and3rson/caveboard/README.md

# CaveBoard

Простий комп'ютер на базі мікропроцесора MOS 6502 (W65C02).

Відео: <https://youtu.be/Klj2Q3trmW8>

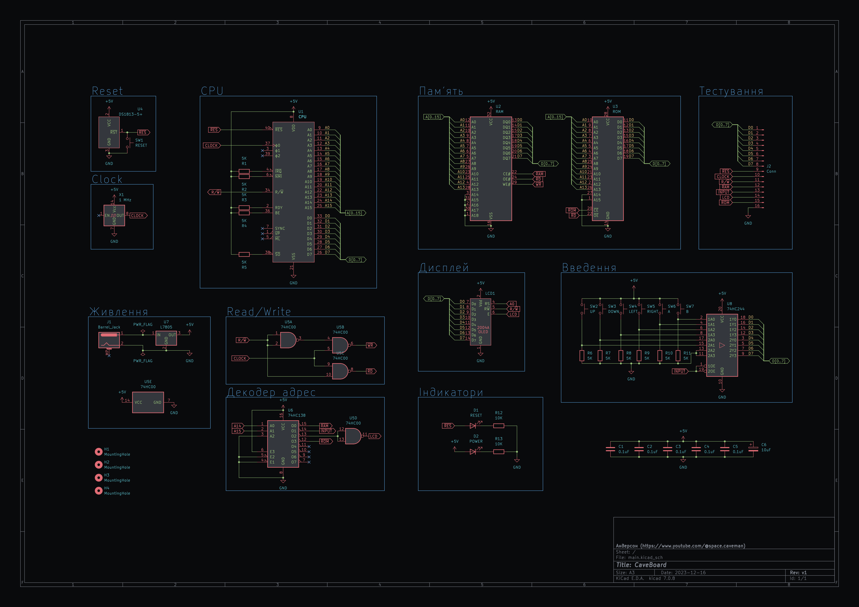
[picture p1: img/schematic.png]
Schematic

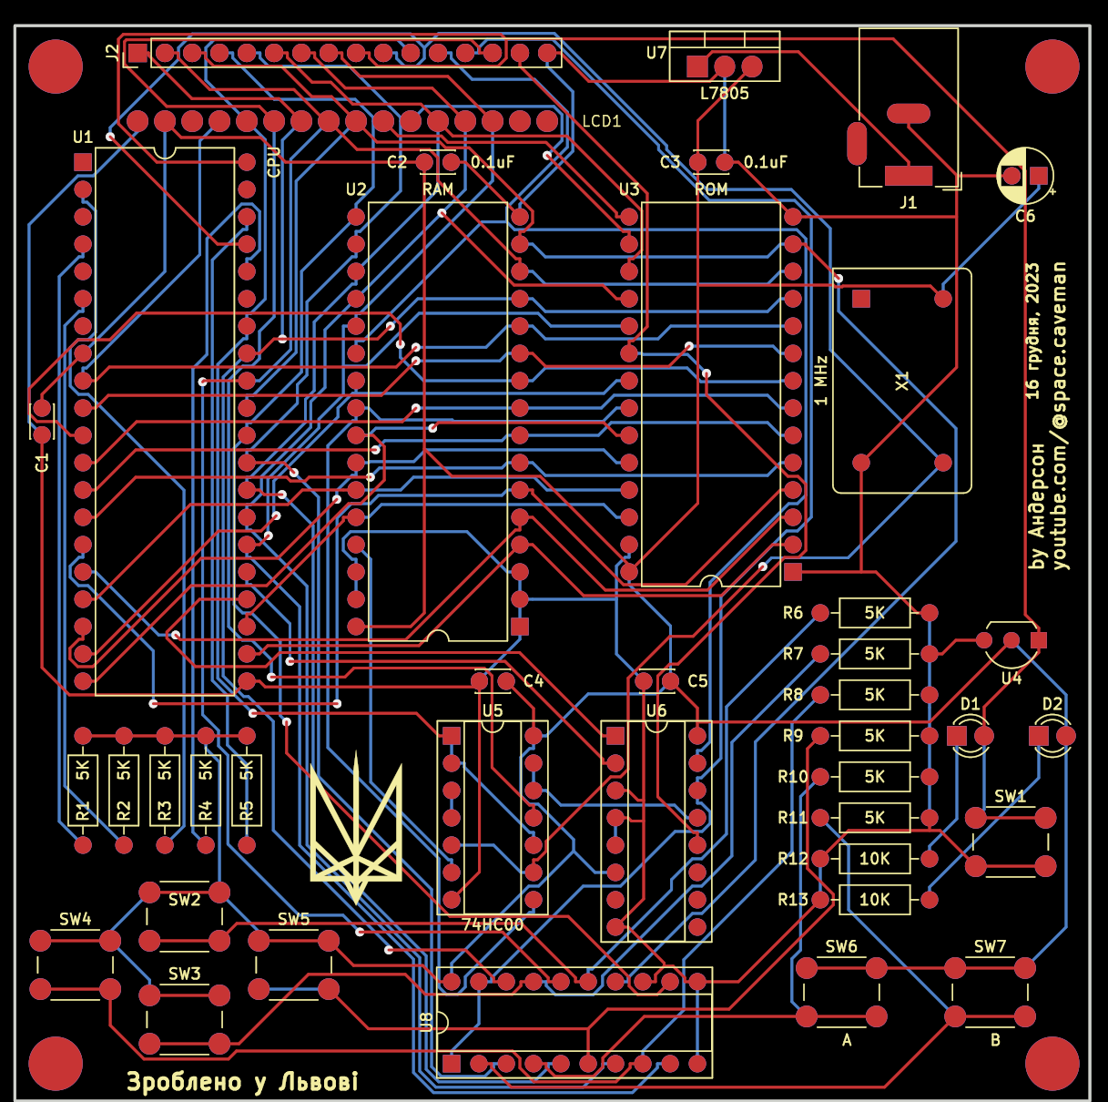
[picture p2: img/pcb.png]
PCB
