and3rson/caveboard/kicad/main.kicad_sch

## KiCad design kicad/main.kicad_sch (2023-12-26)

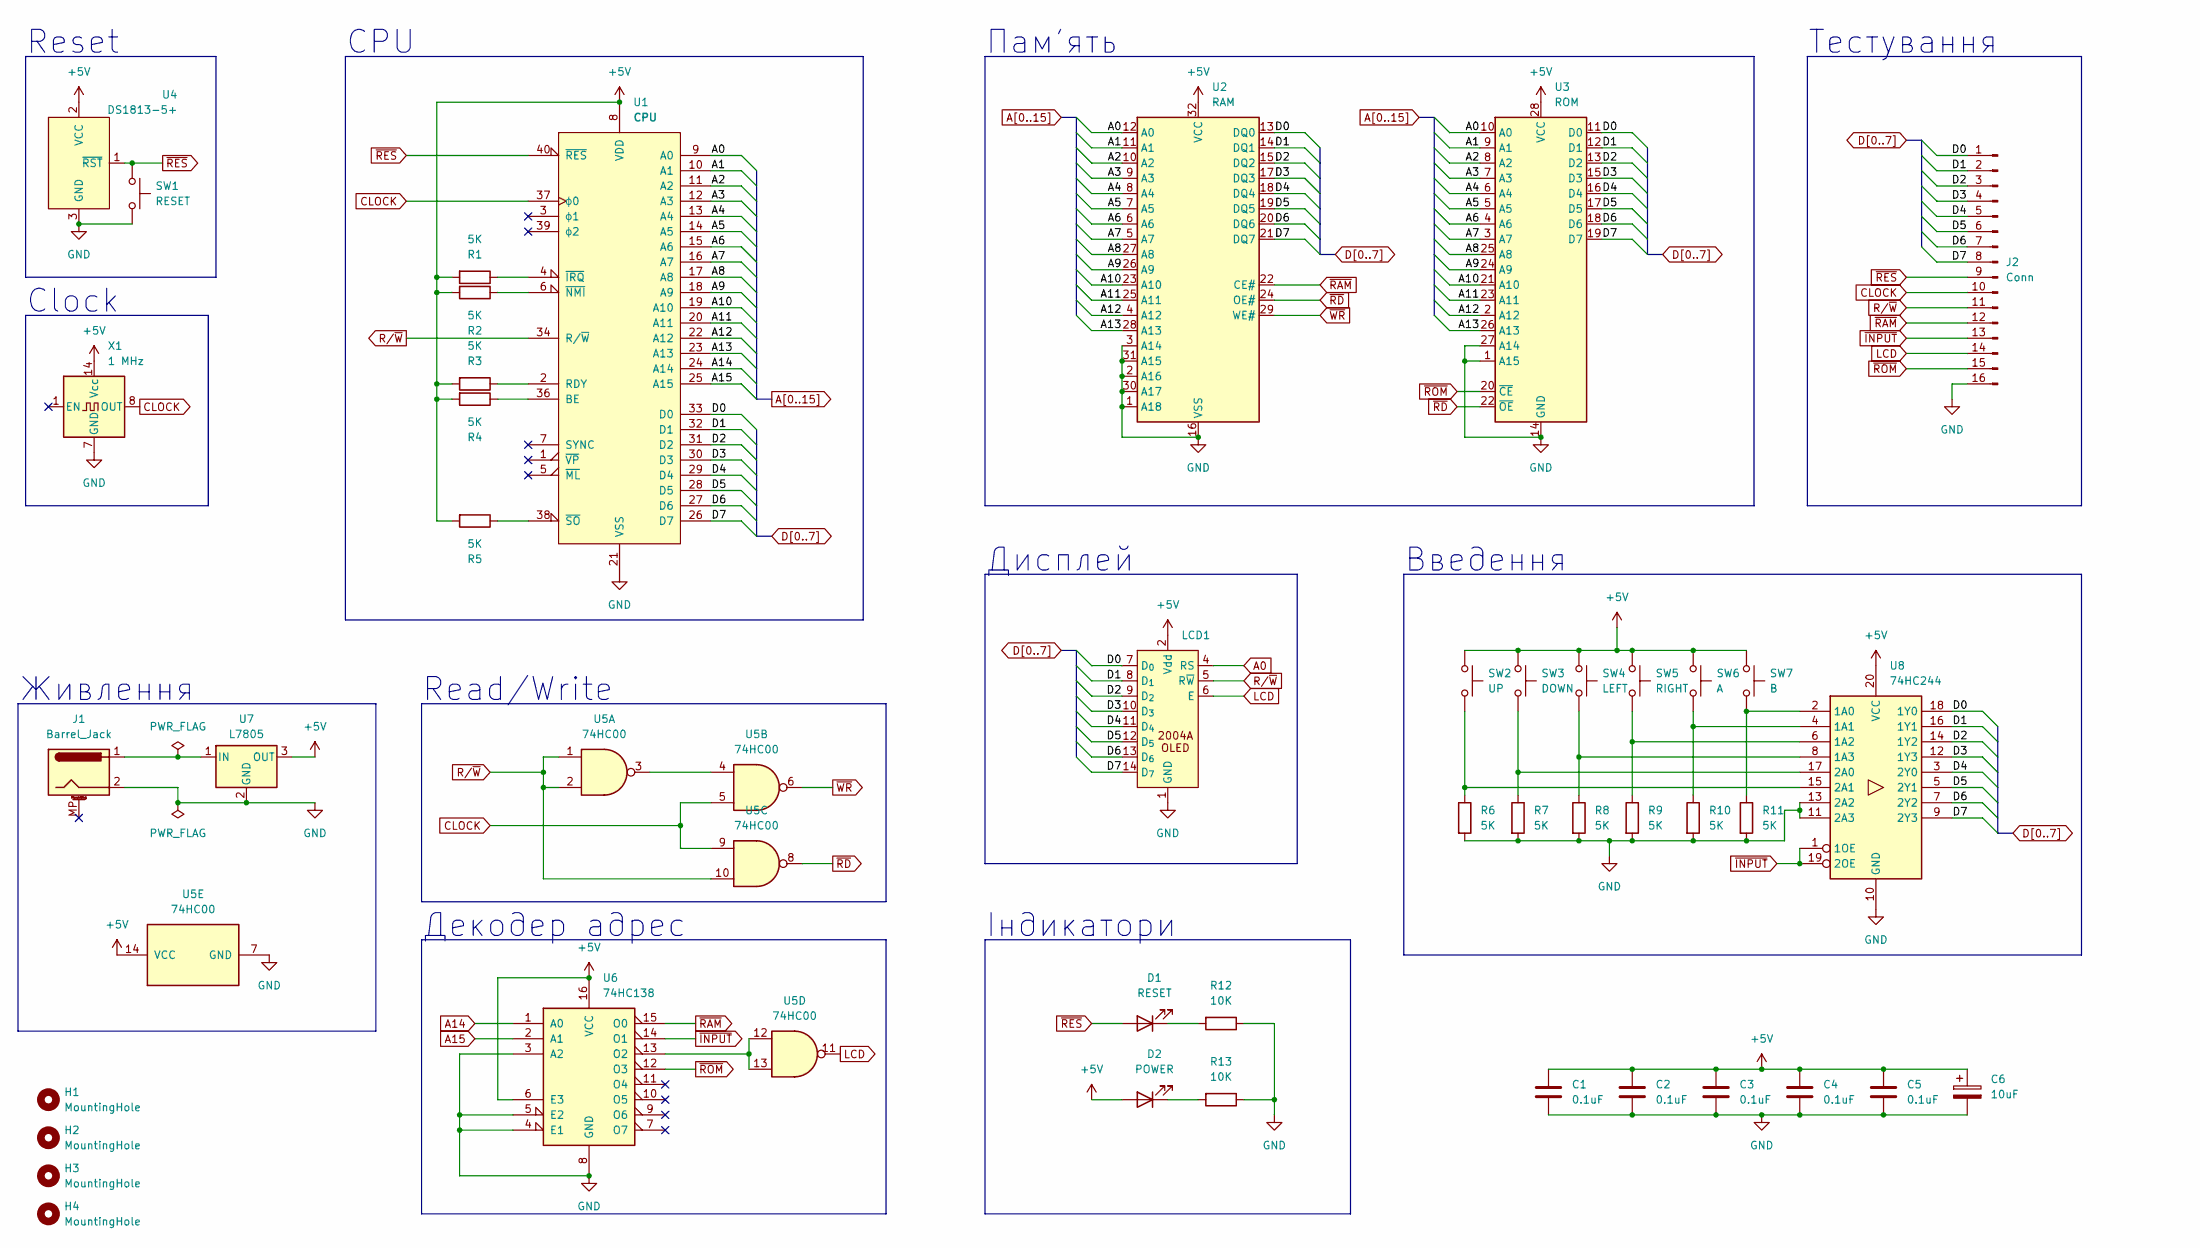
[picture p3: schematic main.kicad_sch]

Parts:
C1, C2, C3, C4, C5: 0.1uF; C_Disc_D3.0mm_W2.0mm_P2.50mm
C6: 10uF; CP_Radial_D5.0mm_P2.50mm
D1: RESET; LED_D3.0mm
D2: POWER; LED_D3.0mm
H1, H2, H3, H4: MountingHole; Hole_3.5x5
J1: Barrel_Jack; BarrelJack_Wuerth_6941xx301002
J2: Conn; PinHeader_1x16_P2.54mm_Vertical
LCD1: 2004A-OLED
R1, R2, R3, R4, R5, R6, R7, R8, R9, R10, R11: 5K; R_Axial_DIN0207_L6.3mm_D2.5mm_P10.16mm_Horizontal
R12, R13: 10K; R_Axial_DIN0207_L6.3mm_D2.5mm_P10.16mm_Horizontal
SW1: RESET; SW_PUSH_6mm_H5mm
SW2: UP; SW_PUSH_6mm_H5mm
SW3: DOWN; SW_PUSH_6mm_H5mm
SW4: LEFT; SW_PUSH_6mm_H5mm
SW5: RIGHT; SW_PUSH_6mm_H5mm
SW6: A; SW_PUSH_6mm_H5mm
SW7: B; SW_PUSH_6mm_H5mm
U1: CPU; DIP-40_W15.24mm
U2: RAM; DIP-32_W15.24mm
U3: ROM; DIP-28_W15.24mm
U4: DS1813-5+; TO-92L_Inline_Wide
U5: 74HC00; DIP-14_W7.62mm_Socket
U6: 74HC138; DIP-16_W7.62mm_Socket
U7: L7805; TO-220-3_Vertical
U8: 74HC244; DIP-20_W7.62mm_Socket
X1: 1 MHz; Oscillator_DIP-14

Connections:
+5V: C1.1, C2.1, C3.1, C4.1, C5.1, C6.1, D2.2 (A), LCD1.2 (Vdd), R1.2, R2.2, R3.2, R4.2, R5.2, SW2.1, SW3.1, SW4.1, SW5.1, SW6.1, SW7.1, U1.8 (VDD), U2.32 (VCC), U3.28 (VCC), U4.2 (VCC), U5.14 (VCC), U6.6 (E3), U6.16 (VCC), U7.3 (OUT), U8.20 (VCC), X1.14 (Vcc)
A0: LCD1.4 (RS), U1.9 (A0), U2.12 (A0), U3.10 (A0)
A1: U1.10 (A1), U2.11 (A1), U3.9 (A1)
A2: U1.11 (A2), U2.10 (A2), U3.8 (A2)
A3: U1.12 (A3), U2.9 (A3), U3.7 (A3)
A4: U1.13 (A4), U2.8 (A4), U3.6 (A4)
A5: U1.14 (A5), U2.7 (A5), U3.5 (A5)
A6: U1.15 (A6), U2.6 (A6), U3.4 (A6)
A7: U1.16 (A7), U2.5 (A7), U3.3 (A7)
A8: U1.17 (A8), U2.27 (A8), U3.25 (A8)
A9: U1.18 (A9), U2.26 (A9), U3.24 (A9)
A10: U1.19 (A10), U2.23 (A10), U3.21 (A10)
A11: U1.20 (A11), U2.25 (A11), U3.23 (A11)
A12: U1.22 (A12), U2.4 (A12), U3.2 (A12)
A13: U1.23 (A13), U2.28 (A13), U3.26 (A13)
A14: U1.24 (A14), U6.1 (A0)
A15: U1.25 (A15), U6.2 (A1)
CLOCK: J2.10, U1.37 (ϕ0), U5.5, U5.9, X1.8 (OUT)
D0: J2.1, LCD1.7 (D_{0}), U1.33 (D0), U2.13 (DQ0), U3.11 (D0), U8.18 (1Y0)
D1: J2.2, LCD1.8 (D_{1}), U1.32 (D1), U2.14 (DQ1), U3.12 (D1), U8.16 (1Y1)
D2: J2.3, LCD1.9 (D_{2}), U1.31 (D2), U2.15 (DQ2), U3.13 (D2), U8.14 (1Y2)
D3: J2.4, LCD1.10 (D_{3}), U1.30 (D3), U2.17 (DQ3), U3.15 (D3), U8.12 (1Y3)
D4: J2.5, LCD1.11 (D_{4}), U1.29 (D4), U2.18 (DQ4), U3.16 (D4), U8.3 (2Y0)
D5: J2.6, LCD1.12 (D_{5}), U1.28 (D5), U2.19 (DQ5), U3.17 (D5), U8.5 (2Y1)
D6: J2.7, LCD1.13 (D_{6}), U1.27 (D6), U2.20 (DQ6), U3.18 (D6), U8.7 (2Y2)
D7: J2.8, LCD1.14 (D_{7}), U1.26 (D7), U2.21 (DQ7), U3.19 (D7), U8.9 (2Y3)
GND: C1.2, C2.2, C3.2, C4.2, C5.2, C6.2, J1.2, J2.16, LCD1.1 (GND), R6.2, R7.2, R8.2, R9.2, R10.2, R11.2, R12.1, R13.1, SW1.2, U1.21 (VSS), U2.1 (A18), U2.2 (A16), U2.3 (A14), U2.16 (VSS), U2.30 (A17), U2.31 (A15), U3.1 (A15), U3.14 (GND), U3.27 (A14), U4.3 (GND), U5.7 (GND), U6.3 (A2), U6.4 (E1), U6.5 (E2), U6.8 (GND), U7.2 (GND), U8.10 (GND), U8.11 (2A3), U8.13 (2A2), X1.7 (GND)
LCD: J2.14, LCD1.6 (E), U5.11
unnamed: D1.1 (K), R12.2
unnamed: D2.1 (K), R13.2
unnamed: J1.1, U7.1 (IN)
unnamed: R1.1, U1.4 (~IRQ)
unnamed: R2.1, U1.6 (~NMI)
unnamed: R3.1, U1.2 (RDY)
unnamed: R4.1, U1.36 (BE)
unnamed: R5.1, U1.38 (~SO)
unnamed: R6.1, SW2.2, U8.15 (2A1)
unnamed: R7.1, SW3.2, U8.17 (2A0)
unnamed: R8.1, SW4.2, U8.8 (1A3)
unnamed: R9.1, SW5.2, U8.6 (1A2)
unnamed: R10.1, SW6.2, U8.4 (1A1)
unnamed: R11.1, SW7.2, U8.2 (1A0)
unnamed: U5.3, U5.4
unnamed: U5.12, U5.13, U6.13 (O2)
R/~W: J2.11, LCD1.5 (R~W), U1.34 (R/~W), U5.1, U5.2, U5.10
~INPUT: J2.13, U6.14 (O1), U8.1 (1OE), U8.19 (2OE)
~RAM: J2.12, U2.22 (CE#), U6.15 (O0)
~RD: U2.24 (OE#), U3.22 (~OE), U5.8
~RES: D1.2 (A), J2.9, SW1.1, U1.40 (~RES), U4.1 (~RST)
~ROM: J2.15, U3.20 (~CE), U6.12 (O3)
~WR: U2.29 (WE#), U5.6

Notes on the sheet:
Тестування
Декодер адрес
Reset
Clock
Живлення
Пам'ять
Введення
Дисплей
Індикатори
CPU
Read/Write
