and3rson/caveboard/(commit log)

2023-12-26 Cleanup board, add mounting holes
    [main-Board.gbr, main-Bot.gbr, main-BotMask.gbr, main-DrillPlated.drl, main-Plated.drl, main-Top.gbr, main-TopMask.gbr, main-TopSilk.gbr]
2023-12-26 Add images
    [main.kicad_sch]
